SmileyNiloc/ArduinoShieldTimer/README.md

This is the repository to house the project files for an Arduino Shield that was designed to function as a cloud synced timer with adafruit.
The file "Colin Aten - Timer IoT device report.pdf" contains most of the information about the project.
