SmileyNiloc/ArduinoShieldTimer/C_Aten_298_shield/298_shield.kicad_pcb

## KiCad design C_Aten_298_shield/298_shield.kicad_pcb (2024-11-03)

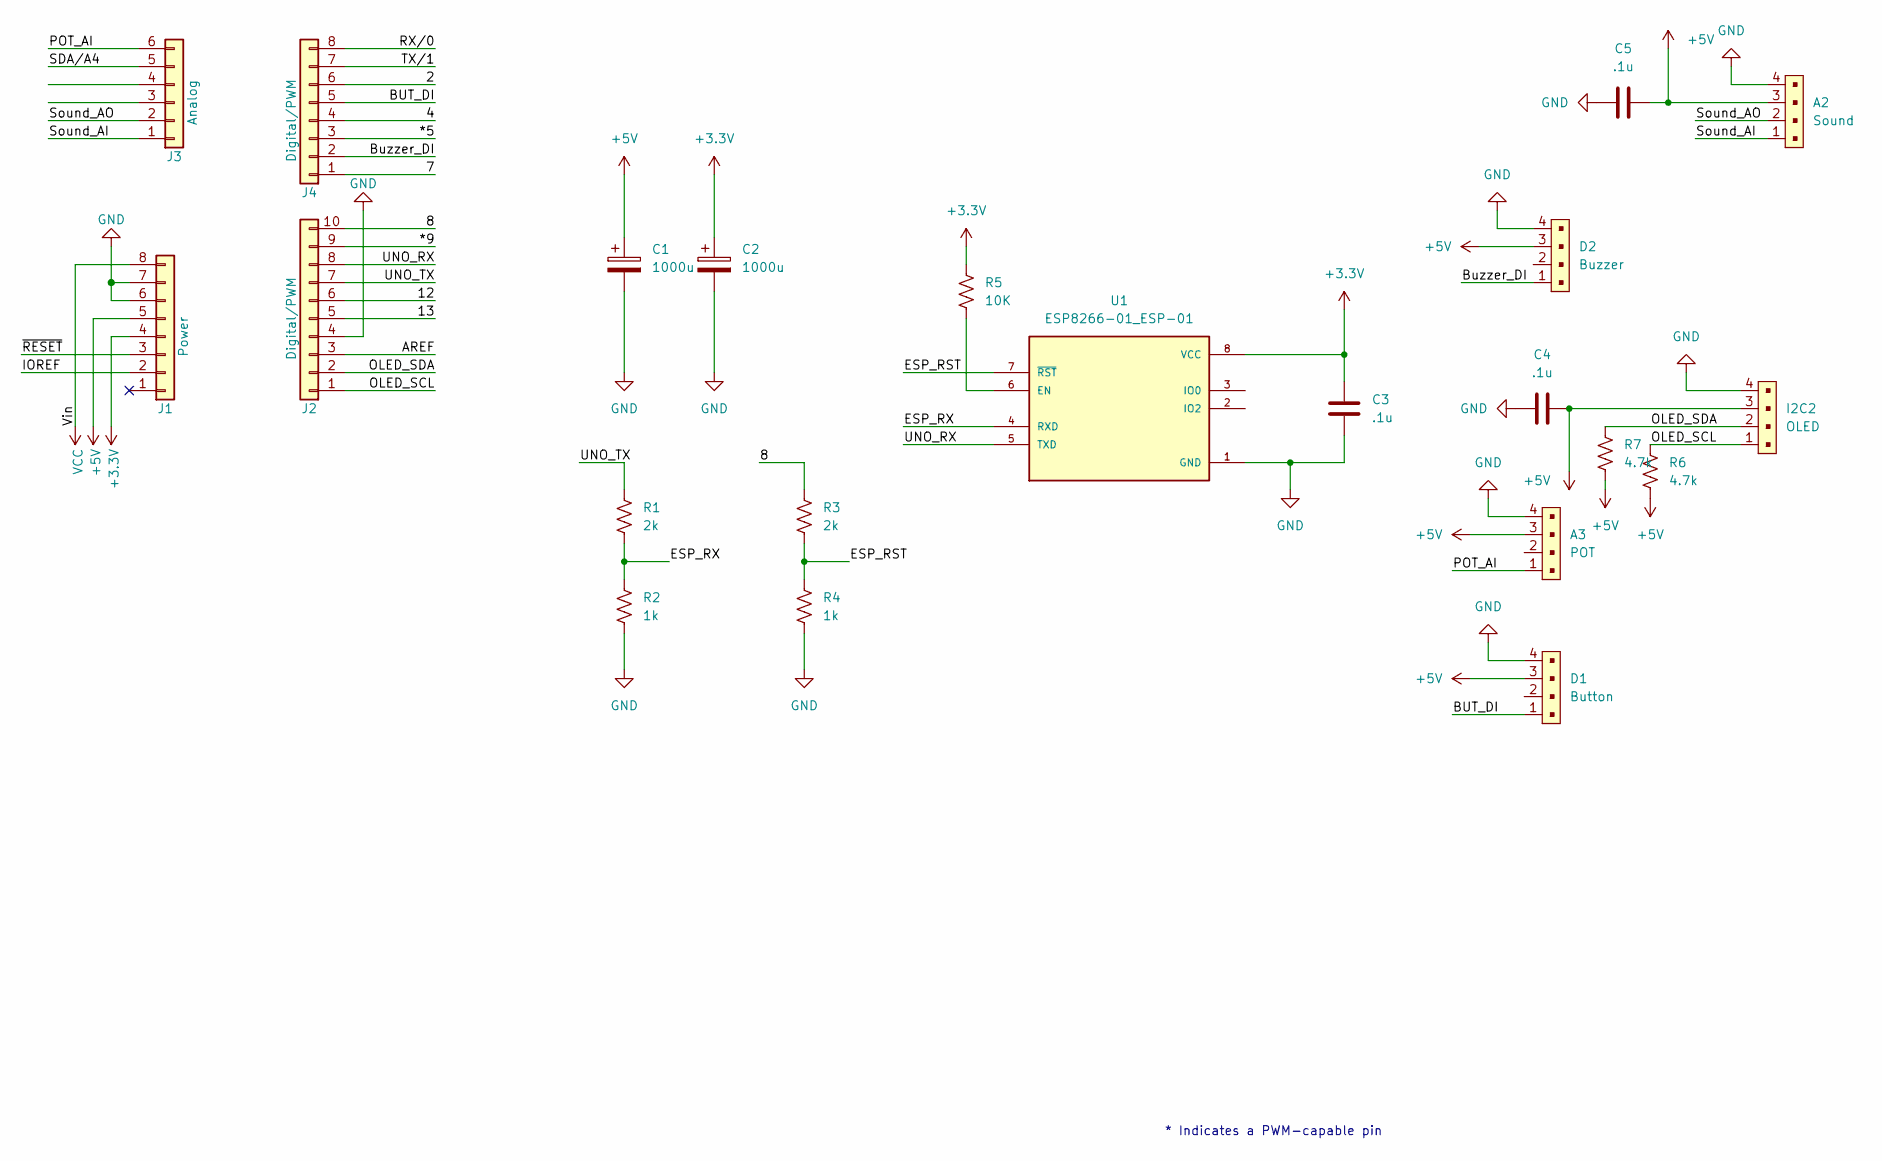
[picture p7: schematic 298_shield.kicad_sch]

Parts:
A2: Sound; PinHeader_1x4_P2mm_Drill1mm; MPN B4B-PH-K-S(LF)(SN)
A3: POT; PinHeader_1x4_P2mm_Drill1mm; MPN B4B-PH-K-S(LF)(SN)
C1, C2: 1000u; CP_Radial_D10.0mm_P5.00mm
C3, C4, C5: .1u
D1: Button; PinHeader_1x4_P2mm_Drill1mm; MPN B4B-PH-K-S(LF)(SN)
D2: Buzzer; PinHeader_1x4_P2mm_Drill1mm; MPN B4B-PH-K-S(LF)(SN)
I2C2: OLED; PinHeader_1x4_P2mm_Drill1mm; MPN B4B-PH-K-S(LF)(SN)
J1: Power; PinSocket_1x08_P2.54mm_Vertical
J2: Digital/PWM; PinSocket_1x10_P2.54mm_Vertical
J3: Analog; PinSocket_1x06_P2.54mm_Vertical
J4: Digital/PWM; PinSocket_1x08_P2.54mm_Vertical
R1, R3: 2k; R_Axial_DIN0207_L6.3mm_D2.5mm_P10.16mm_Horizontal
R2, R4: 1k; R_Axial_DIN0207_L6.3mm_D2.5mm_P10.16mm_Horizontal
R5: 10K; R_Axial_DIN0207_L6.3mm_D2.5mm_P10.16mm_Horizontal
R6, R7: 4.7k; R_Axial_DIN0207_L6.3mm_D2.5mm_P10.16mm_Horizontal
U1: ESP8266-01_ESP-01; XCVR_ESP8266-01_ESP-01; PARTREV V1.2

Connections:
+3.3V: C2.1, C3.1, J1.4, R5.1, U1.8 (VCC)
+5V: A2.3, A3.3, C1.1, C4.2, C5.2, D1.3, D2.3, I2C2.3, J1.5, R6.2, R7.2; also elsewhere on the board
/2: J4.6
/4: J4.4
/7: J4.1
/8: J2.10, R3.1
/12: J2.6
/13: J2.5
/*5: J4.3
/*9: J2.9
/AREF: J2.3
/BUT_DI: D1.1, J4.5
/Buzzer_DI: D2.1, J4.2
/ESP_RST: R3.2, R4.1, U1.7 (~RST)
/ESP_RX: R1.2, R2.1, U1.4 (RXD)
/IOREF: J1.2
/OLED_SCL: I2C2.1, J2.1, R6.1
/OLED_SDA: I2C2.2, J2.2, R7.1
/POT_AI: A3.1, J3.6
/RX/0: J4.8
/SDA/A4: J3.5
/Sound_AI: A2.1, J3.1; also elsewhere on the board
/Sound_AO: A2.2, J3.2; also elsewhere on the board
/TX/1: J4.7
/UNO_RX: J2.8, U1.5 (TXD)
/UNO_TX: J2.7, R1.1
/~RESET: J1.3
GND: A2.4, A3.4, C1.2, C2.2, C3.2, C4.1, C5.1, D1.4, D2.4, I2C2.4, J1.6, J1.7, J2.4, R2.2, R4.2, U1.1 (GND)
unnamed: R5.2, U1.6 (EN)
VCC: J1.8

Notes on the sheet:
* Indicates a PWM-capable pin

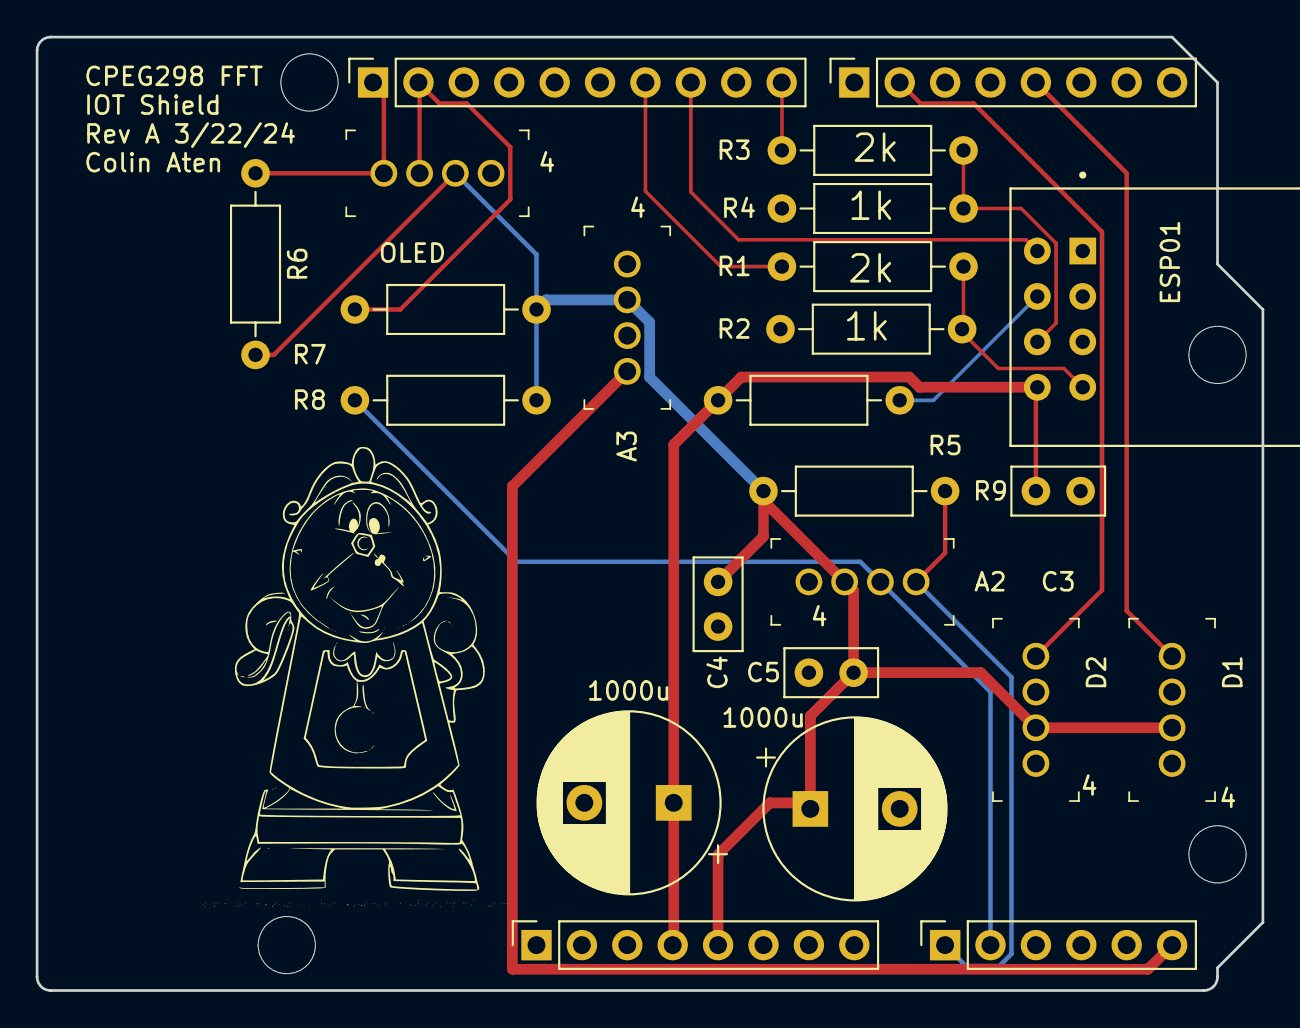
[picture p8: board 298_shield.kicad_pcb from above]

Board: 2 copper layers, 68.6 x 53.3 mm, 28 parts (0 on the bottom side), 16 nets.

Other parts of the board:
MH1, MH2, MH3, MH4: MountingHole_3.2mm
R8, R9: 4.7k; R_Axial_DIN0207_L6.3mm_D2.5mm_P10.16mm_Horizontal

Their connections:
+5V: R8.2, R9.2; also elsewhere on the board
/Sound_AI: R9.1; also elsewhere on the board
/Sound_AO: R8.1; also elsewhere on the board
